mck1117/vr-interface/export/vr_module.pdf

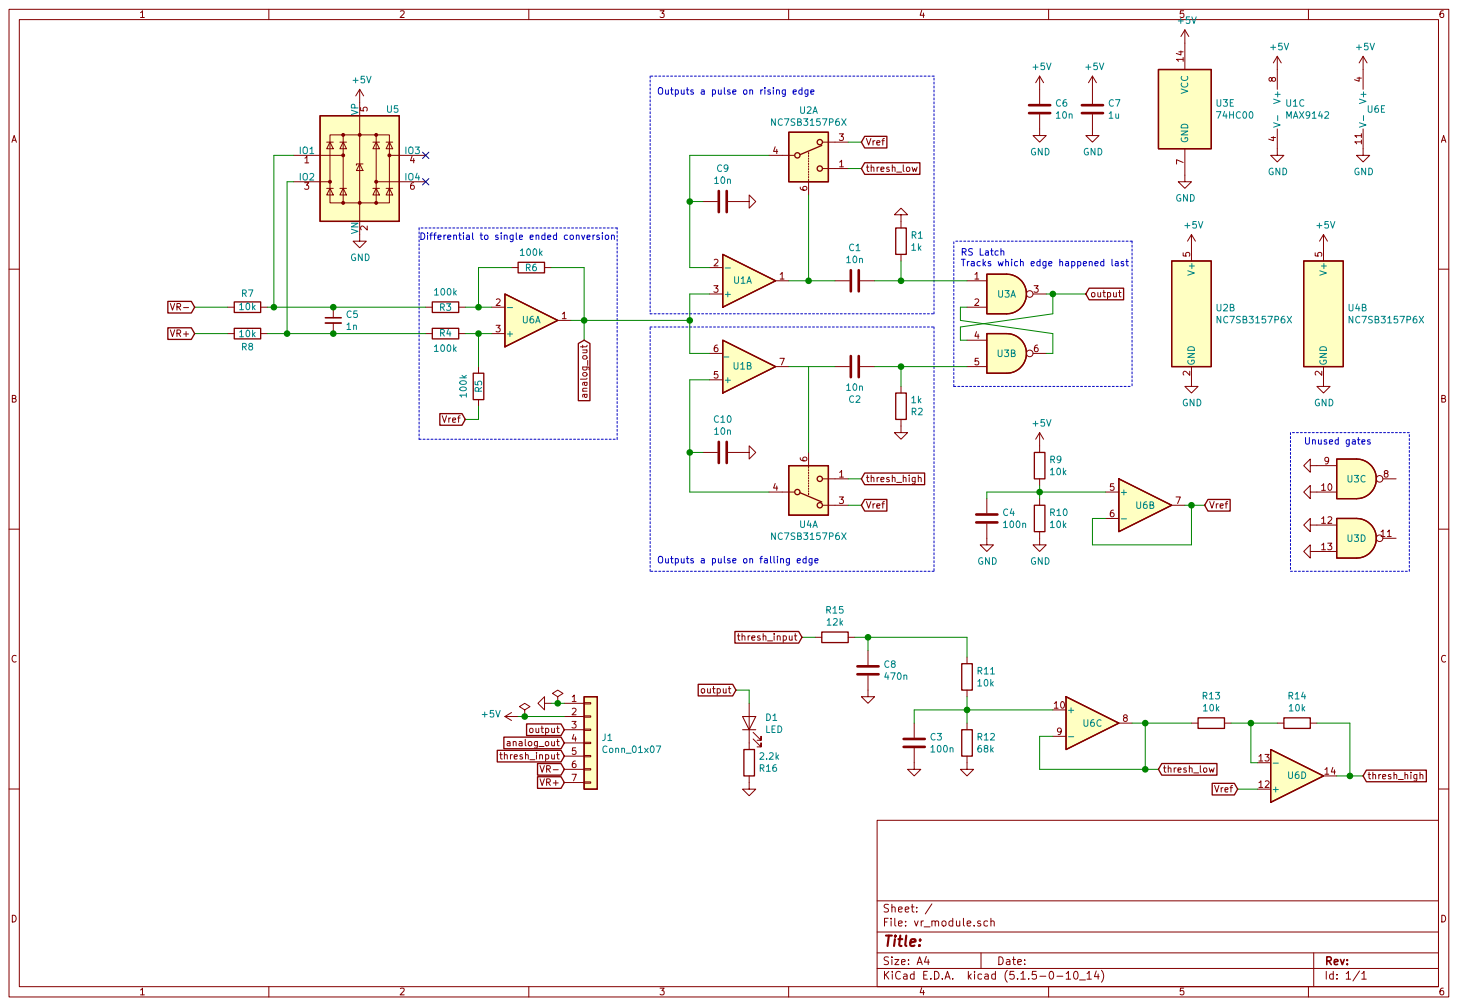
[picture p1: page 1]

Outputs a pulse on rising edge

Differential to single ended conversion

RS Latch Tracks which edge happened last

Outputs a pulse on falling edge
