mck1117/vr-interface/model/VR_Thresholded.asc

A1: srflop; Vhigh=5
C1: cap; 10n
C2: cap; 10n
C3: cap; 10n
C4: cap; 10n
C5: cap; 1n
D1: diode
D2: diode
R1: res; 100k
R2: res; 100k
R3: res; 100k
R4: res; 100k
R5: res; 20
R6: res; 20
R7: res; 20
R8: res; 20
R9: res; 1k
R10: res; 1k
R11: res; 10k
R12: res; 10k
S3: sw
S4: sw
S5: sw
S6: sw
U1: AD8628
U2: LT1720
U4: LT1720
V1: voltage; 2.5
V2: voltage; 5
V3: voltage; SINE(0 2.2 100); AC 1
V4: voltage; 1.5
V5: voltage; 3.5
V6: voltage; SINE(0 0.2 20k)
Named nets: 0, vcc, vref, out, v_th, out2, v_th2, clean_out, rise_pulse, fall_pulse, analog
.model SW SW(Ron=1m Roff=1Meg Vt=2 Vh=-0.2)
Differential to single ended conversion
.tran 10m
V5 sets high arming threshold
V4 sets low arming threshold
