mck1117/vr-interface/vr_module.kicad_pcb

## KiCad design vr_module.kicad_pcb (2021-02-04)

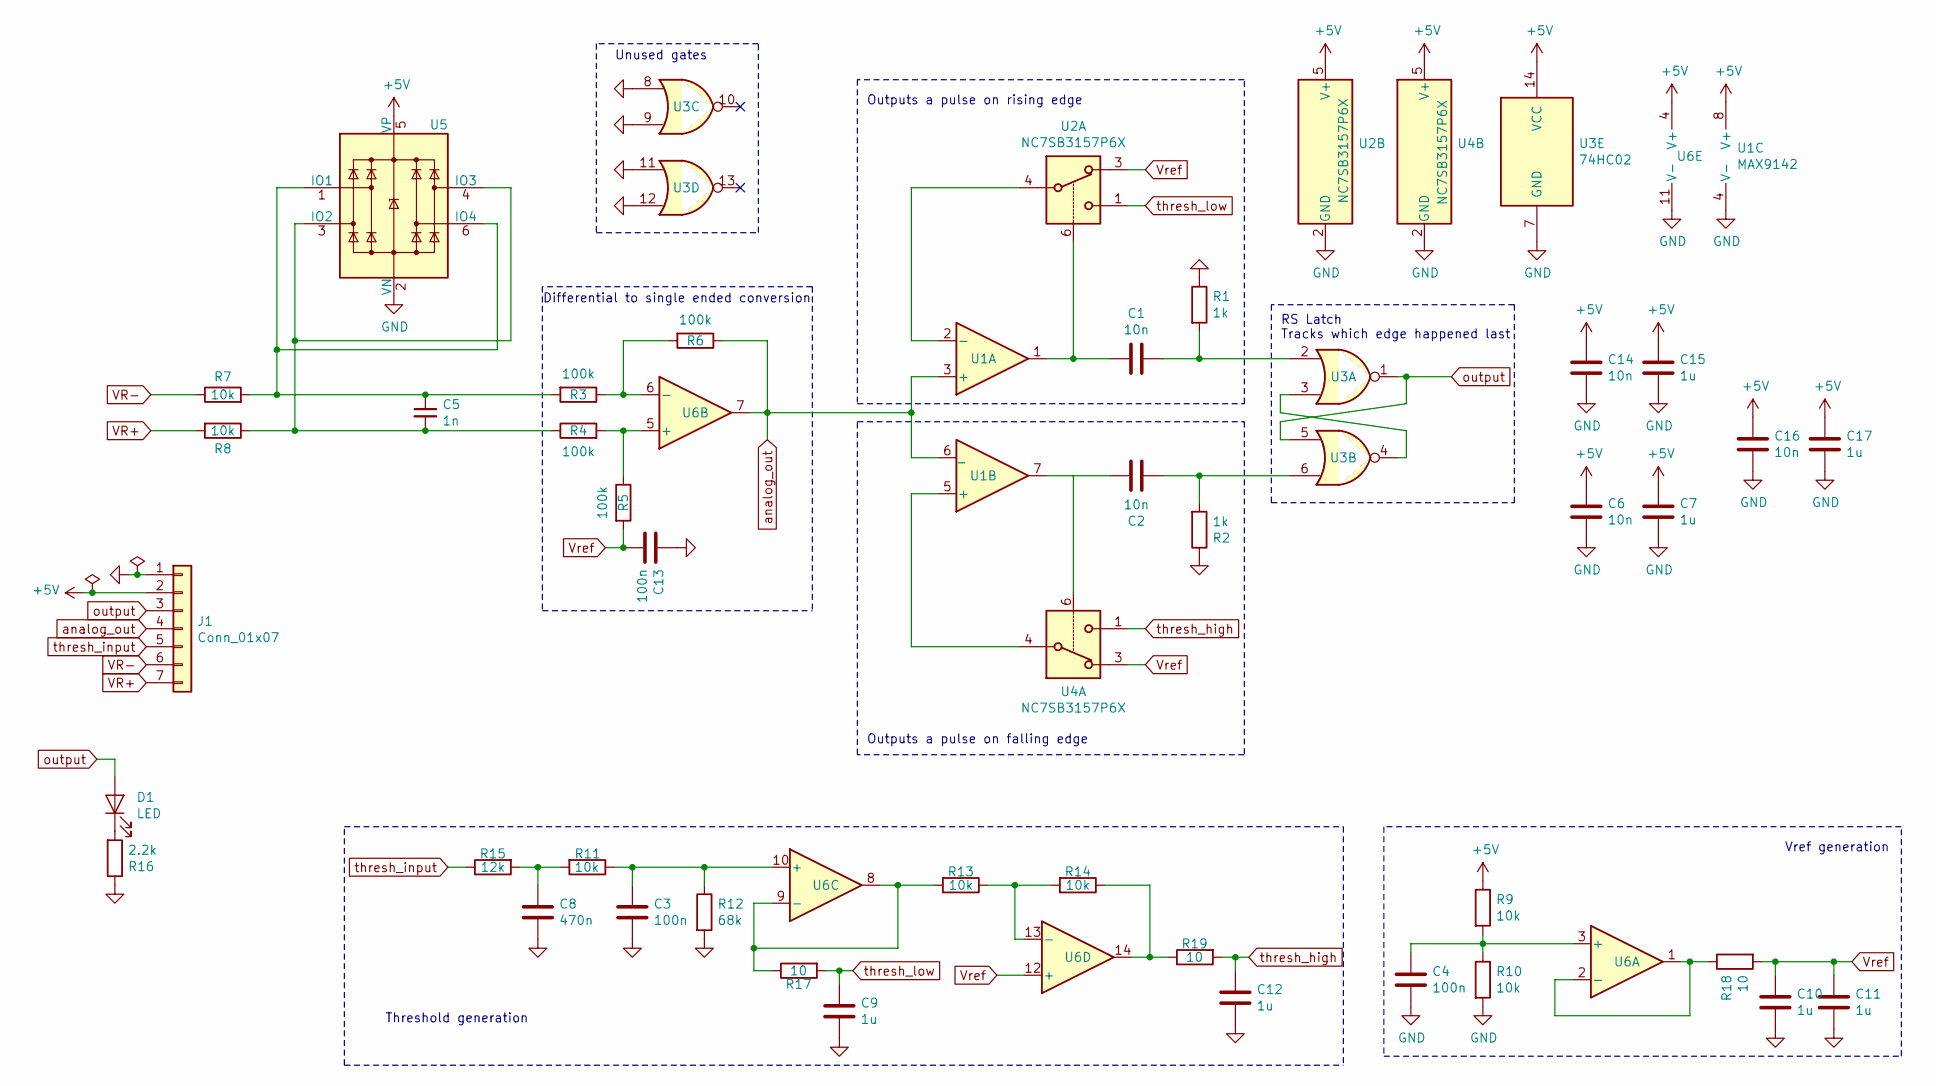
[picture p2: schematic vr_module.sch]

Parts:
C1, C2, C6, C14, C16: 10n; C_0402_1005Metric; LCSC C15195
C3, C4, C13: 100n; C_0402_1005Metric; LCSC C1525
C5: 1n; C_0402_1005Metric; LCSC C1523
C7, C9, C10, C11, C12, C15, C17: 1u; C_0402_1005Metric; LCSC C52923
C8: 470n; C_0402_1005Metric; LCSC C47339
D1: LED; LED_0603_1608Metric; LCSC C72043
J1: Conn_01x07; PinHeader_1x07_P2.54mm_Vertical
R1, R2: 1k; R_0402_1005Metric; LCSC C11702
R3, R4, R5, R6: 100k; R_0402_1005Metric; LCSC C25741
R7, R8: 10k; R_0805_2012Metric; LCSC C17414
R9, R10, R11, R13, R14: 10k; R_0402_1005Metric; LCSC C25744
R12: 68k; R_0402_1005Metric; LCSC C36871
R15: 12k; R_0402_1005Metric; LCSC C25752
R16: 2.2k; R_0402_1005Metric; LCSC C25879
R17, R18, R19: 10; R_0402_1005Metric; LCSC C25077
U1: MAX9142; SOIC-8_3.9x4.9mm_P1.27mm; LCSC C18567
U2, U4: NC7SB3157P6X; SOT-363_SC-70-6; LCSC C87403
U3: 74HC02; SOIC-14_3.9x8.7mm_P1.27mm; LCSC C5588
U5: SRV05-4; SOT-23-6; LCSC C85364
U6: MCP6004; TSSOP-14_4.4x5mm_P0.65mm; LCSC C50282

Connections:
+5V: C6.1, C7.1, C14.1, C15.1, C16.1, C17.1, J1.2, R9.1, U1.8 (V+), U2.5 (V+), U3.14 (VCC), U4.5 (V+), U5.5 (VP), U6.4 (V+)
GND: C3.2, C4.2, C6.2, C7.2, C8.2, C9.2, C10.2, C11.2, C12.2, C13.1, C14.2, C15.2, C16.2, C17.2, J1.1, R1.1, R2.1, R10.2, R12.2, R16.1, U1.4 (V-), U2.2 (GND), U3.7 (GND), U3.8, U3.9, U3.11, U3.12, U4.2 (GND), U5.2 (VN), U6.11 (V-)
unnamed: C1.1, R1.2, U3.2
unnamed: C1.2, U1.1, U2.6
unnamed: C2.1, R2.2, U3.6
unnamed: C2.2, U1.7, U4.6
unnamed: C3.1, R11.1, R12.1, U6.10 (+)
unnamed: C4.1, R9.2, R10.1, U6.3 (+)
unnamed: C5.1, R3.2, R7.2, U5.1 (IO1), U5.6 (IO4)
unnamed: C5.2, R4.1, R8.1, U5.3 (IO2), U5.4 (IO3)
unnamed: C8.1, R11.2, R15.2
unnamed: D1.1 (K), R16.2
unnamed: R3.1, R6.2, U6.6 (-)
unnamed: R4.2, R5.1, U6.5 (+)
unnamed: R13.1, R14.2, U6.13 (-)
unnamed: R13.2, R17.1, U6.8, U6.9 (-)
unnamed: R14.1, R19.1, U6.14
unnamed: R18.1, U6.1, U6.2 (-)
unnamed: U1.2 (-), U2.4
unnamed: U1.5 (+), U4.4
unnamed: U3.3, U3.4
VR+: J1.7, R8.2
VR-: J1.6, R7.1
Vref: C10.1, C11.1, C13.2, R5.2, R18.2, U2.3, U4.3, U6.12 (+)
analog_out: J1.4, R6.1, U1.3 (+), U1.6 (_), U6.7
output: D1.2 (A), J1.3, U3.1, U3.5
thresh_high: C12.1, R19.2, U4.1
thresh_input: J1.5, R15.1
thresh_low: C9.1, R17.2, U2.1

Notes on the sheet:
Outputs a pulse on rising edge
Outputs a pulse on falling edge
Differential to single ended conversion
RS Latch Tracks which edge happened last
Unused gates
Vref generation
Threshold generation

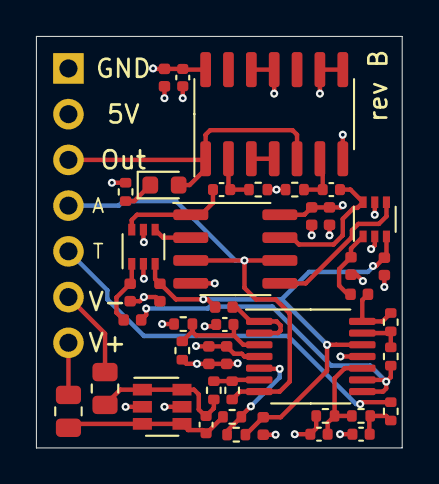
[picture p3: board vr_module.kicad_pcb from above]

Board: 4 copper layers, 20.3 x 22.9 mm, 44 parts (1 on the bottom side), 29 nets.
