mck1117/vr-interface/(threads)

Thread 3 (2021-02-09):

readme.md with mission statement?

rusefillc, 2021-02-09:
85ms?
Matthew Kennedy  1:48 PM

mostly yes

the other thing I'm doing is an actual feature benefit, that the interface converts the VR signal to something an STM32's ADC can look at easily, so you can get an oscilloscope view of the analog VR signal so you don't have to guess about invert vs. not-invert
