mck1117/vr-interface/(commit log)

2021-01-04 add board
    [vr_module.kicad_pcb, vr_module.sch]
2021-01-04 add power caps, silk on bottom
    [vr_module.kicad_pcb, vr_module.sch]
2021-01-04 filter pwm harder
    [vr_module.kicad_pcb, vr_module.sch]
2021-01-05 lcsc numbers, optimize divider
    [vr_module.sch]
2021-01-05 add filter caps
    [vr_module.kicad_pcb, vr_module.sch]
2021-01-05 ground unused inputs to NAND
    [vr_module.kicad_pcb, vr_module.sch]
2021-01-05 upgrade comparator
    [vr_module.kicad_pcb, vr_module.sch]
2021-01-05 I heard we like LEDs
    [vr_module.kicad_pcb, vr_module.sch]
2021-01-05 oh no one comparator was flipped
    [vr_module.kicad_pcb, vr_module.sch]
2021-02-04 rev b improvements
    [vr_module.kicad_pcb, vr_module.sch]
2021-03-27 rev b export
    [vr_module_bom.csv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]
